jaebin401/RAVEN_hardware/images/link image/base_link.png

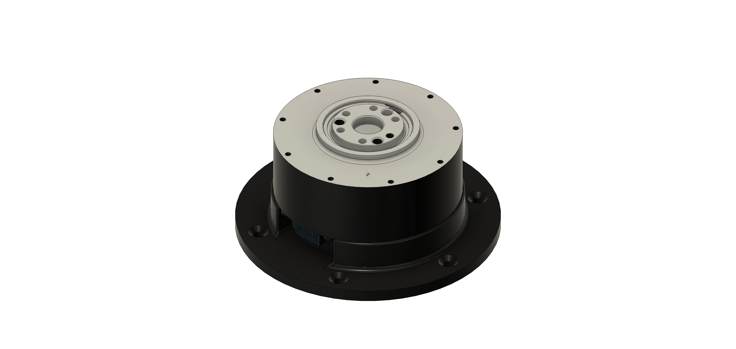
images/link image/base_link.png
