jaebin401/RAVEN_hardware/images/link image/ForeArm_link.png

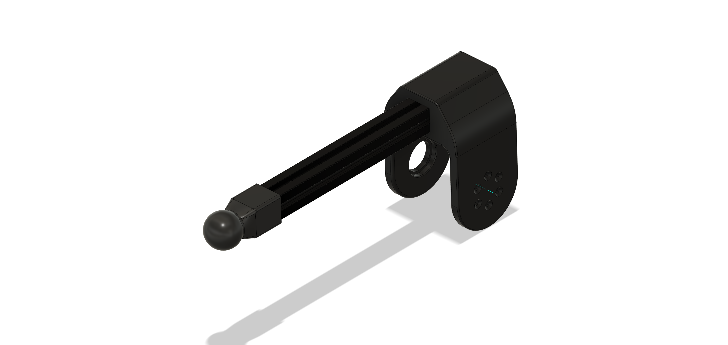
images/link image/ForeArm_link.png
