jaebin401/RAVEN_hardware/images/link image/Shoulder_link.png

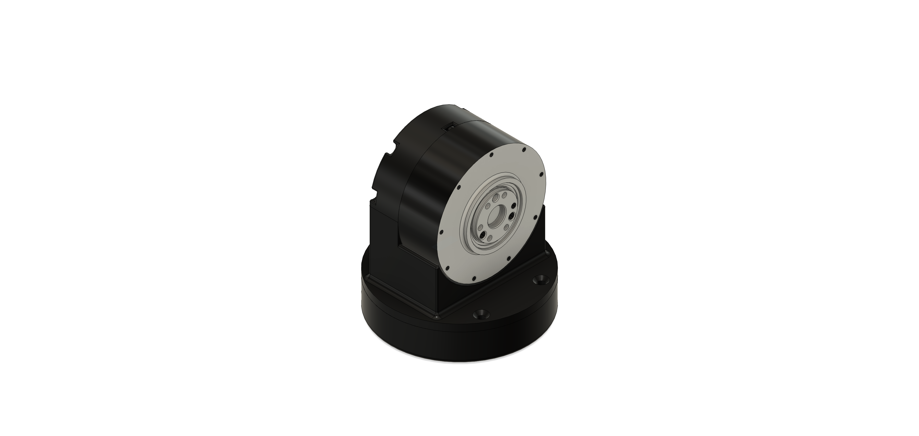
images/link image/Shoulder_link.png
