jaebin401/RAVEN_hardware/images/link image/UpperArm_link.png

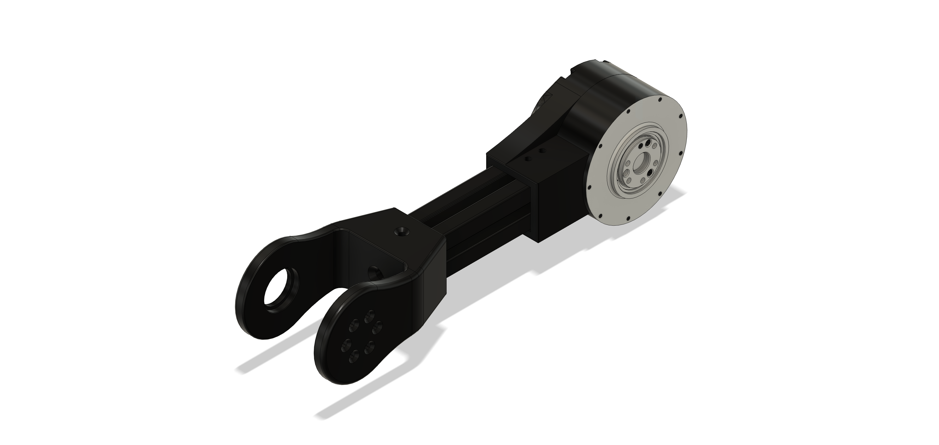
images/link image/UpperArm_link.png
