jaebin401/RAVEN_hardware/images/part image/RVN_3DP_ForeArm_Drive.png

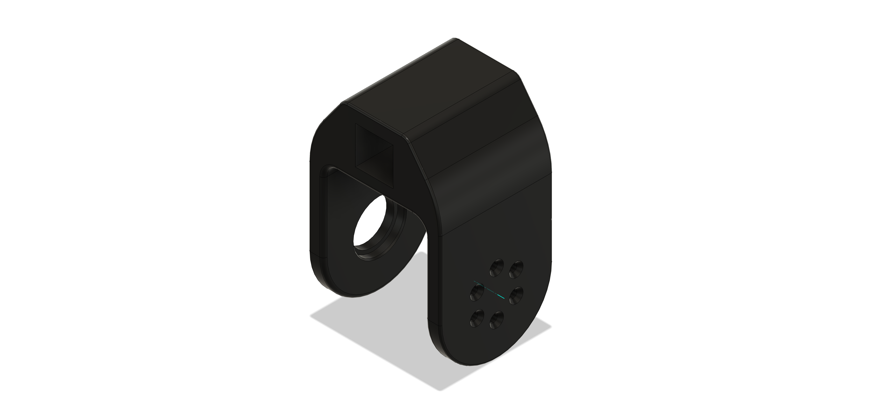
images/part image/RVN_3DP_ForeArm_Drive.png
