jaebin401/RAVEN_hardware/images/part image/RVN_BUY_ForeArm_Frame v1.png

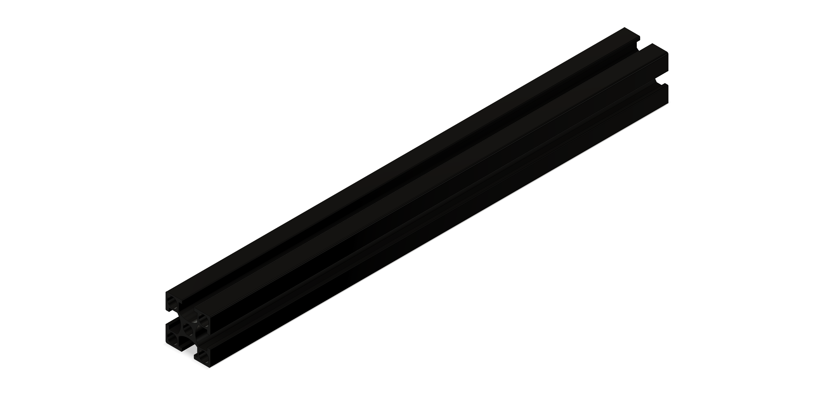
images/part image/RVN_BUY_ForeArm_Frame v1.png
