jaebin401/RAVEN_hardware/images/part image/RVN_BUY_UpperArm_Frame.png

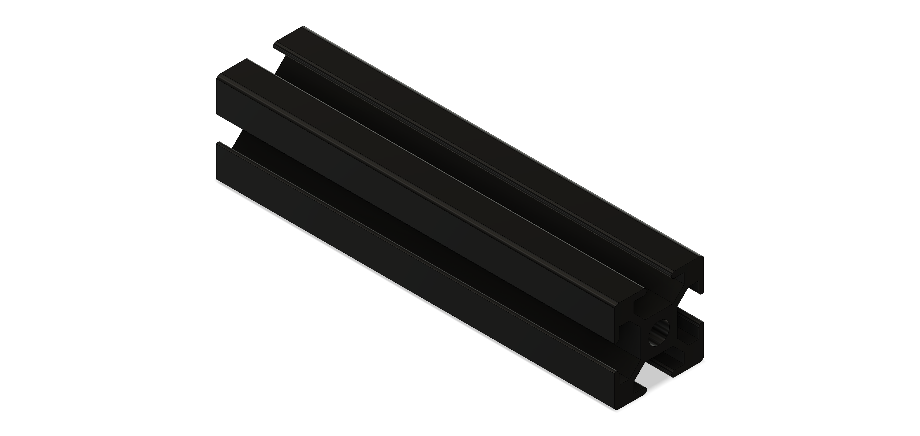
images/part image/RVN_BUY_UpperArm_Frame.png
