jaebin401/RAVEN_hardware/images/RAVEN on RViz2.png

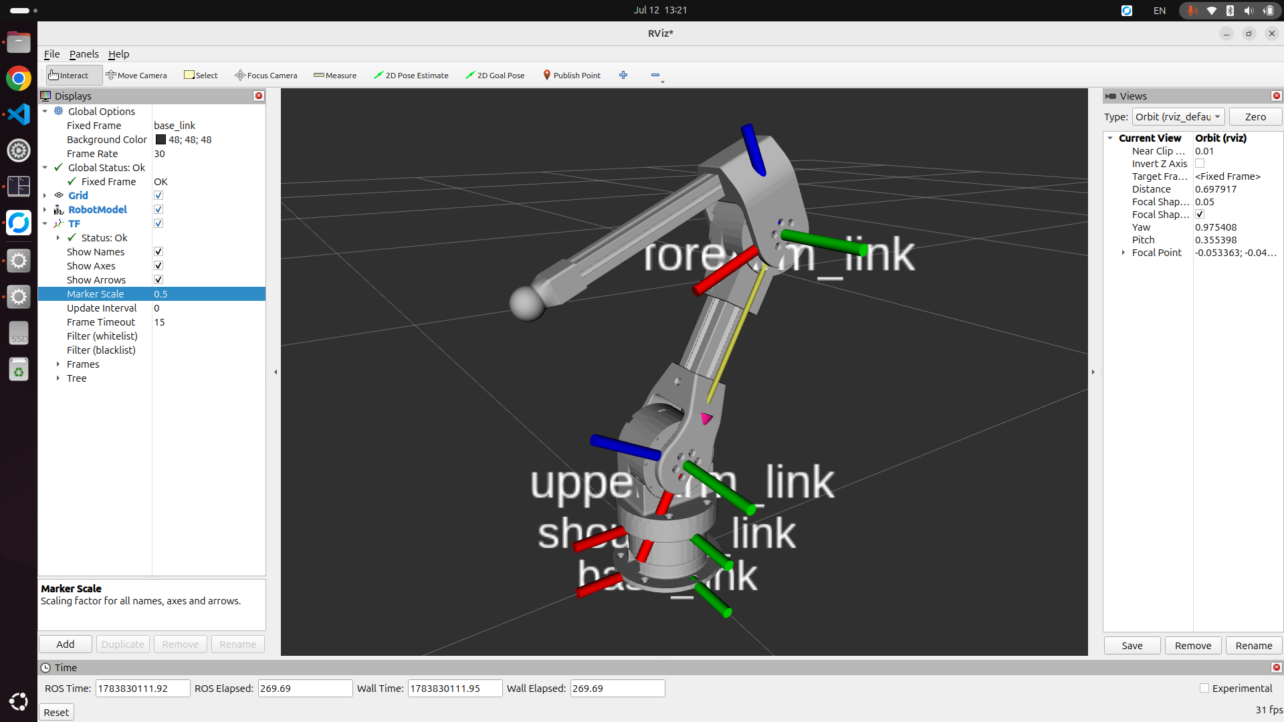
images/RAVEN on RViz2.png
