jaebin401/RAVEN_hardware/images/RAVEN_in_real.jpeg

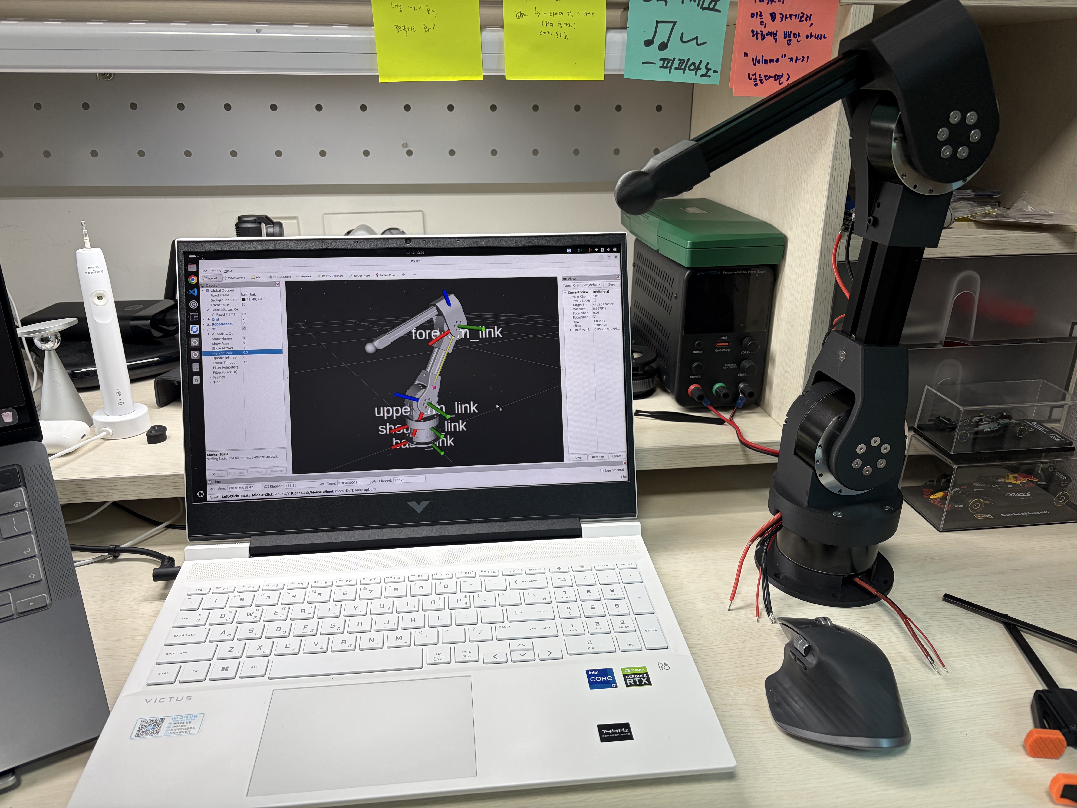
images/RAVEN_in_real.jpeg
