jaebin401/RAVEN_hardware/images/RAVEN_profile.png

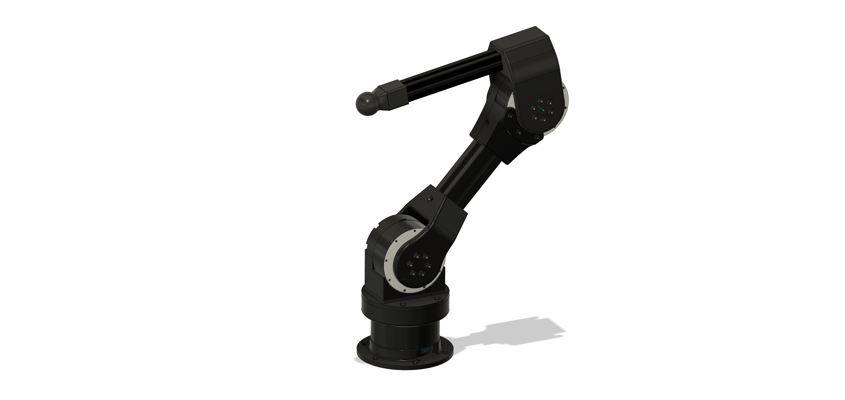
images/RAVEN_profile.png
