jaebin401/RAVEN_hardware/images/RAVEN_profile_portrait.png

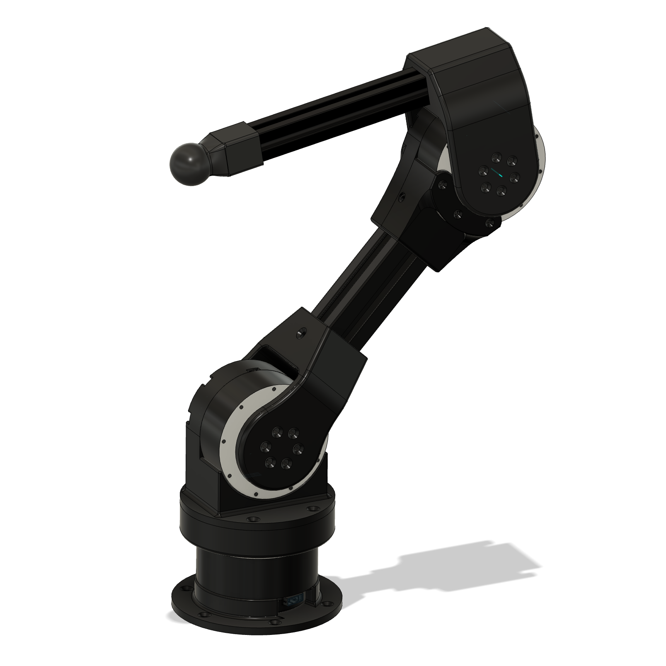
images/RAVEN_profile_portrait.png
