jaebin401/RAVEN_hardware/cad/Link files - .STEP/base_link.step

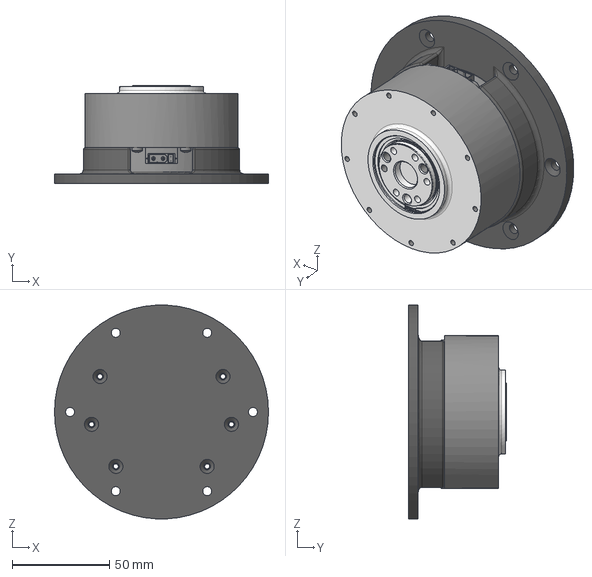
[picture p14: CAD file, 2026-07-12]
cad/Link files - .STEP/base_link.step
110.0 x 50.4 x 109.8 mm
base_link_1
RS02
