jaebin401/RAVEN_hardware/cad/part files - .3mf/030_RVN_3DP_ForeArm_Drive_v1.3mf

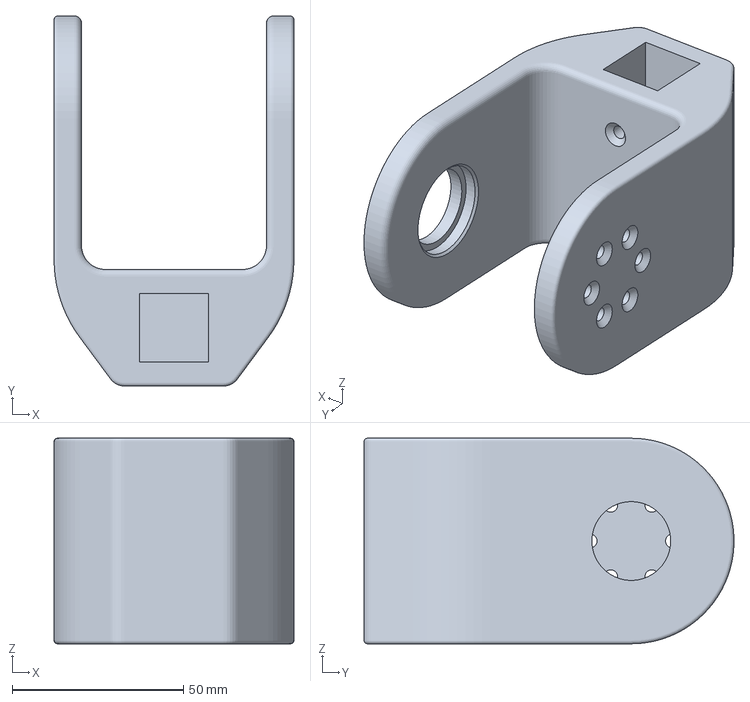
[picture p15: CAD file, 2026-07-14]
cad/part files - .3mf/030_RVN_3DP_ForeArm_Drive_v1.3mf
70.0 x 108.0 x 60.0 mm
