jaebin401/RAVEN_hardware/part files/RVN_BUY_RS02.SLDPRT

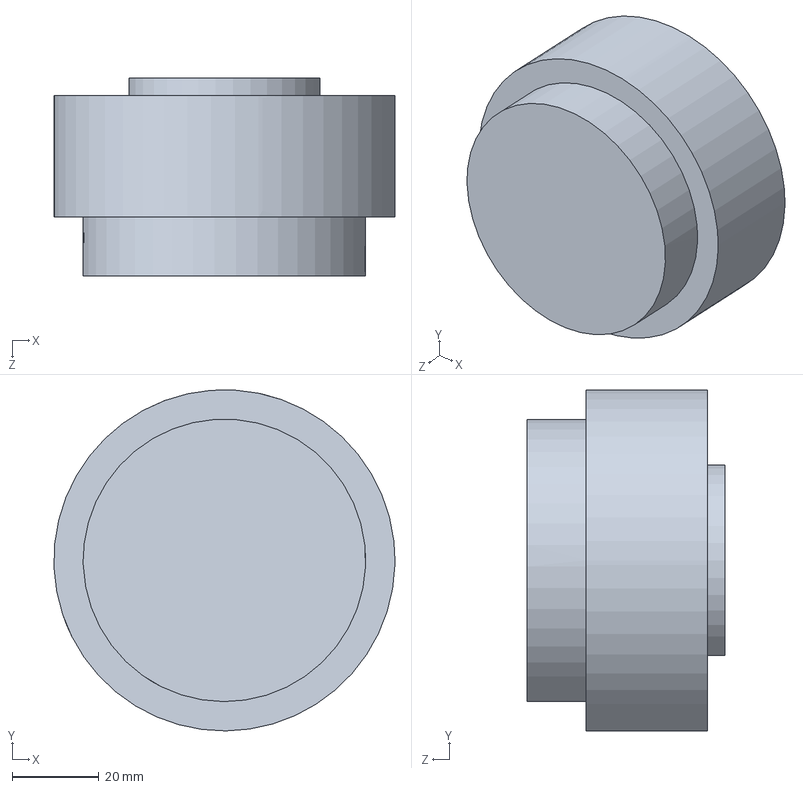
[picture p16: CAD file, 2026-05-31]
part files/RVN_BUY_RS02.SLDPRT
78.5 x 78.4 x 45.5 mm
