jaebin401/RAVEN_hardware/urdf/meshes/upperArm_link.STL

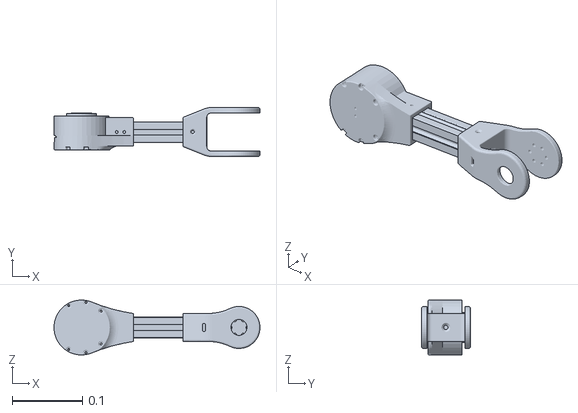
[picture p17: CAD file, 2026-07-11]
urdf/meshes/upperArm_link.STL
0.294 x 0.07 x 0.0785
