jaebin401/RAVEN_hardware/cad/Link files - .STEP/UpperArm_link.step

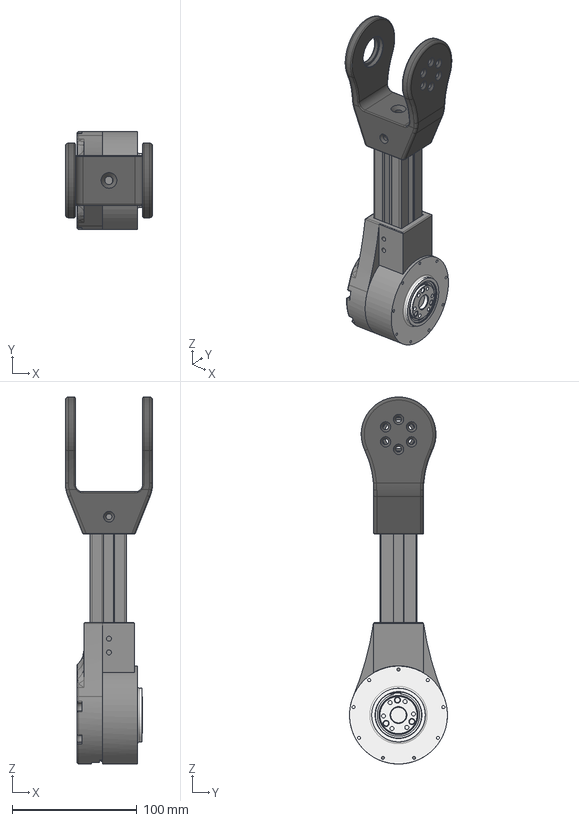
[picture p18: CAD file, 2026-07-12]
cad/Link files - .STEP/UpperArm_link.step
70.0 x 78.5 x 294.2 mm
RVN_3DP_UpperArm_Drive_profile
GFSP6-3030-130
RVN_3DP_UpperArm_MotorMount
RS02
