jaebin401/RAVEN_hardware/cad/part files - .3mf/010_RVN_3DP_Shoulder_MotorMount_v1.3mf

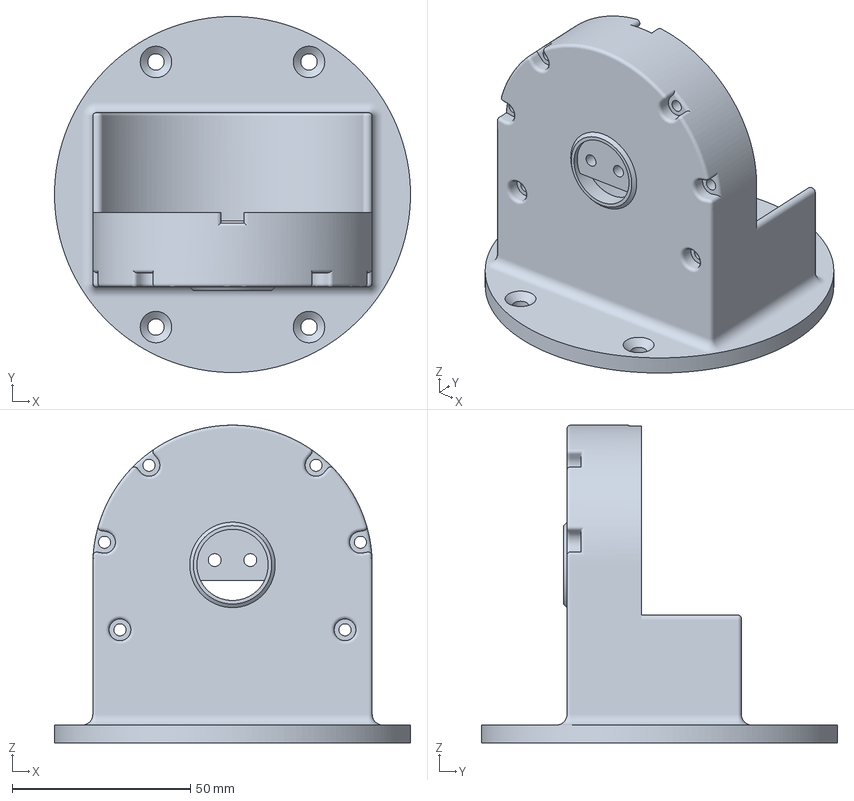
[picture p19: CAD file, 2026-07-14]
cad/part files - .3mf/010_RVN_3DP_Shoulder_MotorMount_v1.3mf
100.0 x 100.0 x 89.3 mm
