jaebin401/RAVEN_hardware/part files/RVN_3DP_Shoulder_Drive_v1.step

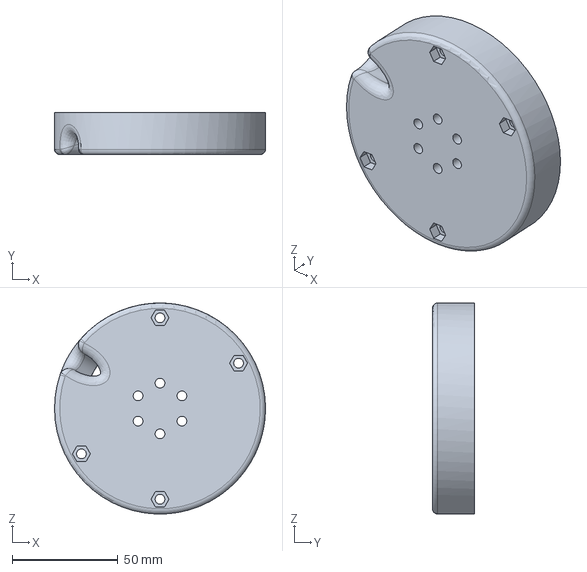
[picture p20: CAD file, 2026-05-31]
part files/RVN_3DP_Shoulder_Drive_v1.step
100.0 x 20.0 x 100.0 mm
