jaebin401/RAVEN_hardware/urdf/meshes/foreArm_link.STL

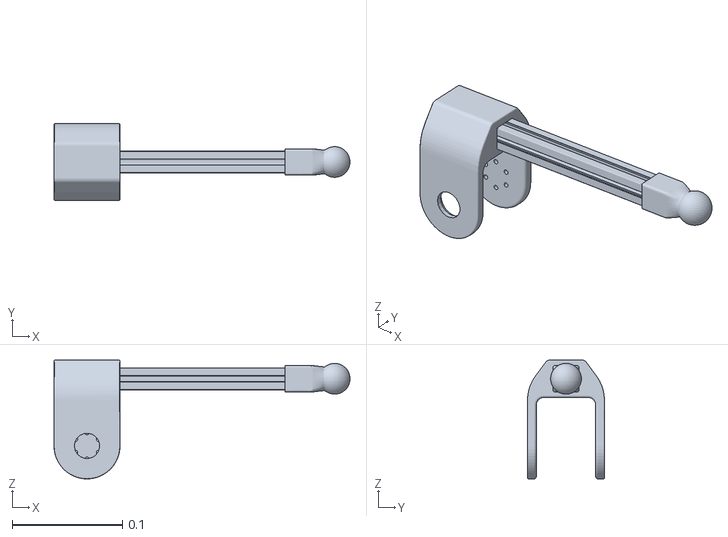
[picture p21: CAD file, 2026-07-11]
urdf/meshes/foreArm_link.STL
0.269 x 0.07 x 0.108
