jaebin401/RAVEN_hardware/cad/Link files - .STEP/ForeArm_link.step

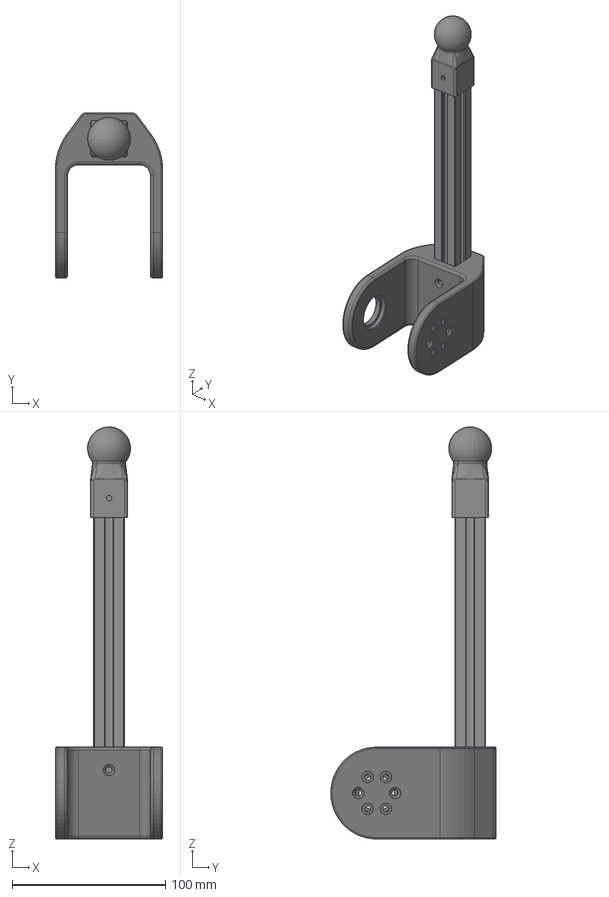
[picture p22: CAD file, 2026-07-12]
cad/Link files - .STEP/ForeArm_link.step
70.0 x 108.0 x 268.9 mm
RVN_BUY_ForeArm_Frame
RVN_3DP_ForeArm_Drive_v3
RVN_3DP_ForeArm_EndEffecter
