jaebin401/RAVEN_hardware/cad/part files - .3mf/031_RVN_3DP_ForeArm_EndEffector_v2.3mf

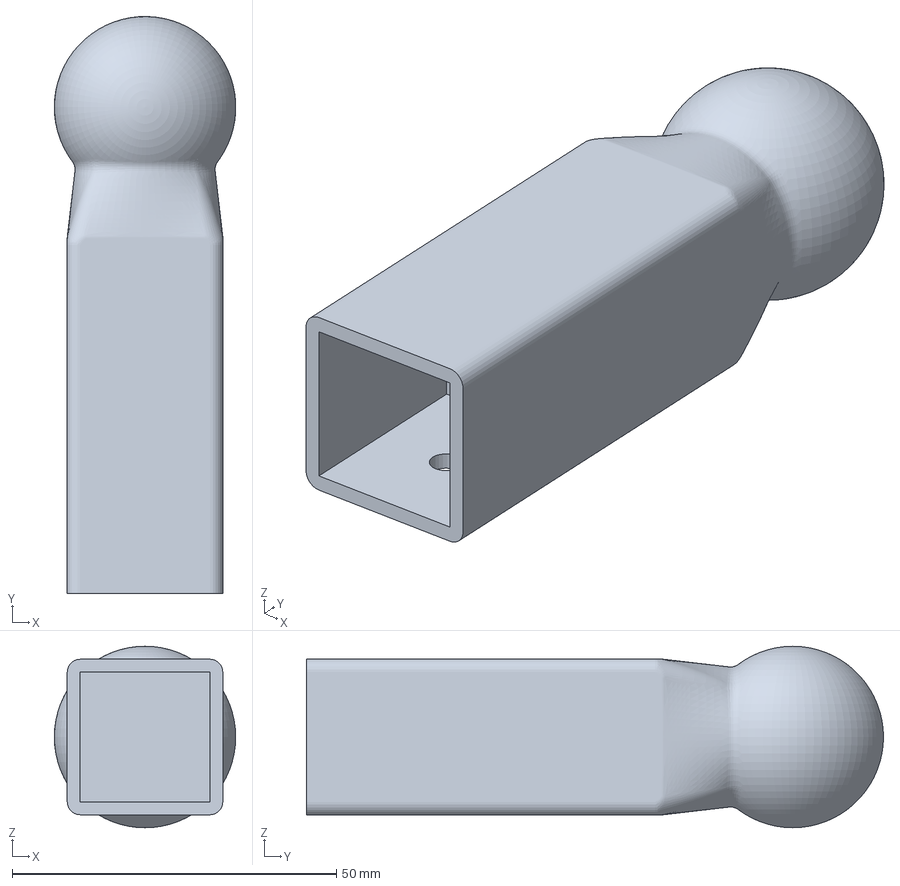
[picture p23: CAD file, 2026-07-14]
cad/part files - .3mf/031_RVN_3DP_ForeArm_EndEffector_v2.3mf
28.0 x 89.0 x 28.0 mm
