jaebin401/RAVEN_hardware/part files/RVN_3DP_UpperArm_Drive_v1.step

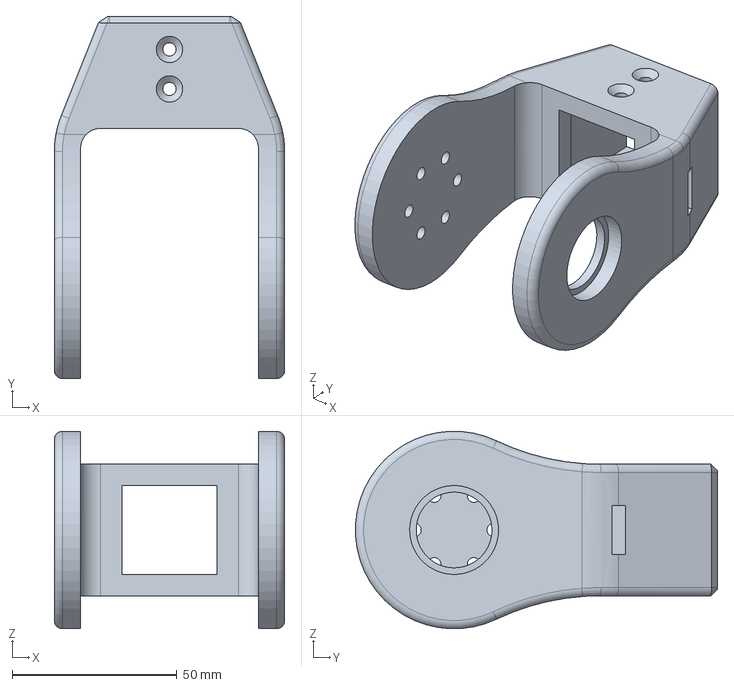
[picture p24: CAD file, 2026-05-31]
part files/RVN_3DP_UpperArm_Drive_v1.step
70.0 x 109.9 x 59.9 mm
