jaebin401/RAVEN_hardware/urdf/meshes/base_link.STL

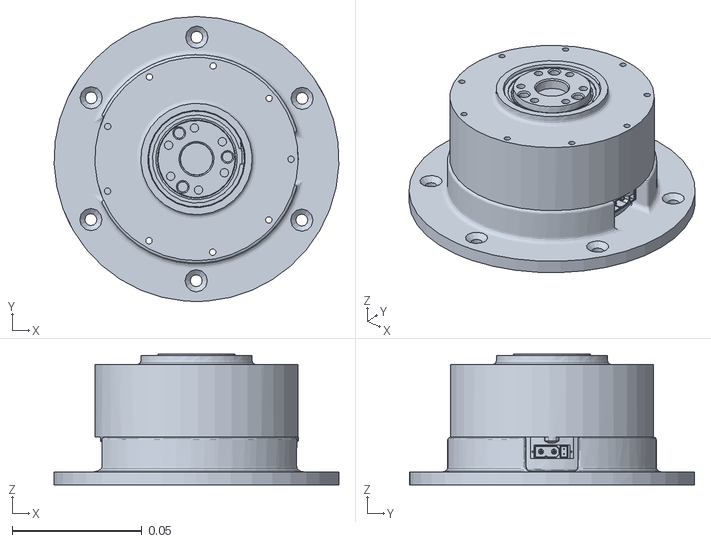
[picture p25: CAD file, 2026-07-11]
urdf/meshes/base_link.STL
0.11 x 0.11 x 0.0504
