jaebin401/RAVEN_hardware/cad/Link files - .STEP/Shoulder_link.step

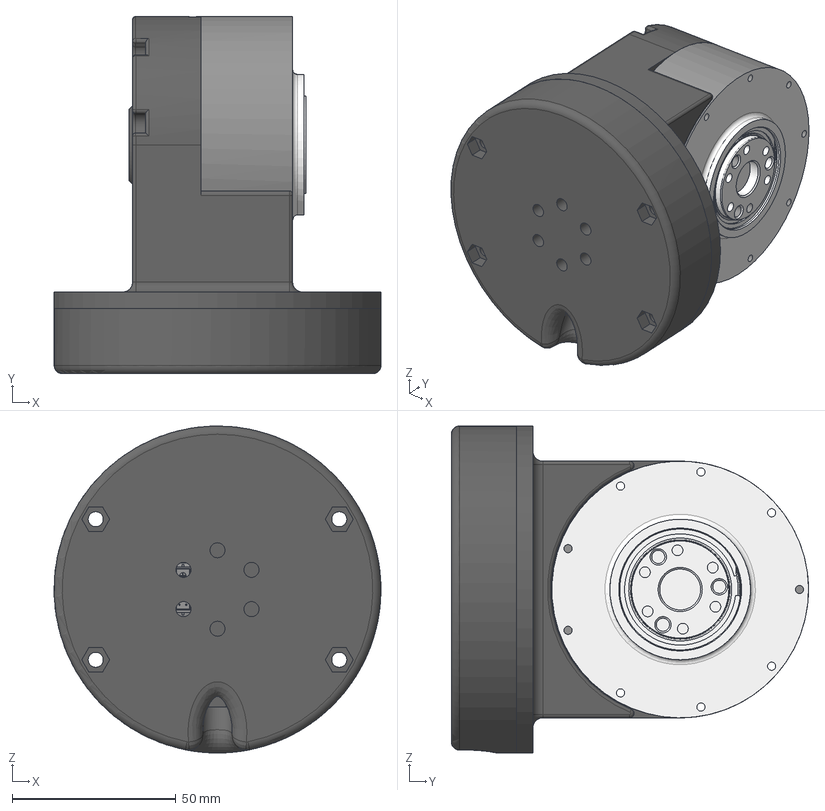
[picture p26: CAD file, 2026-07-12]
cad/Link files - .STEP/Shoulder_link.step
100.0 x 109.3 x 100.0 mm
RVN_3DP_Shoulder_Drive
RVN_3DP_Shoulder_MotorMount
RS02
