jaebin401/RAVEN_hardware/cad/part files - .3mf/000_RVN_3DP_Base_MotorMount_v1.3mf

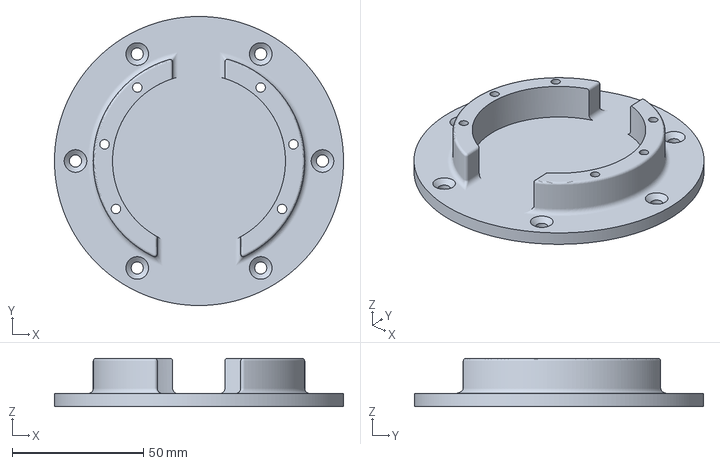
[picture p27: CAD file, 2026-07-14]
cad/part files - .3mf/000_RVN_3DP_Base_MotorMount_v1.3mf
110.0 x 110.0 x 18.4 mm
