jaebin401/RAVEN_hardware/urdf/meshes/shoulder_link.STL

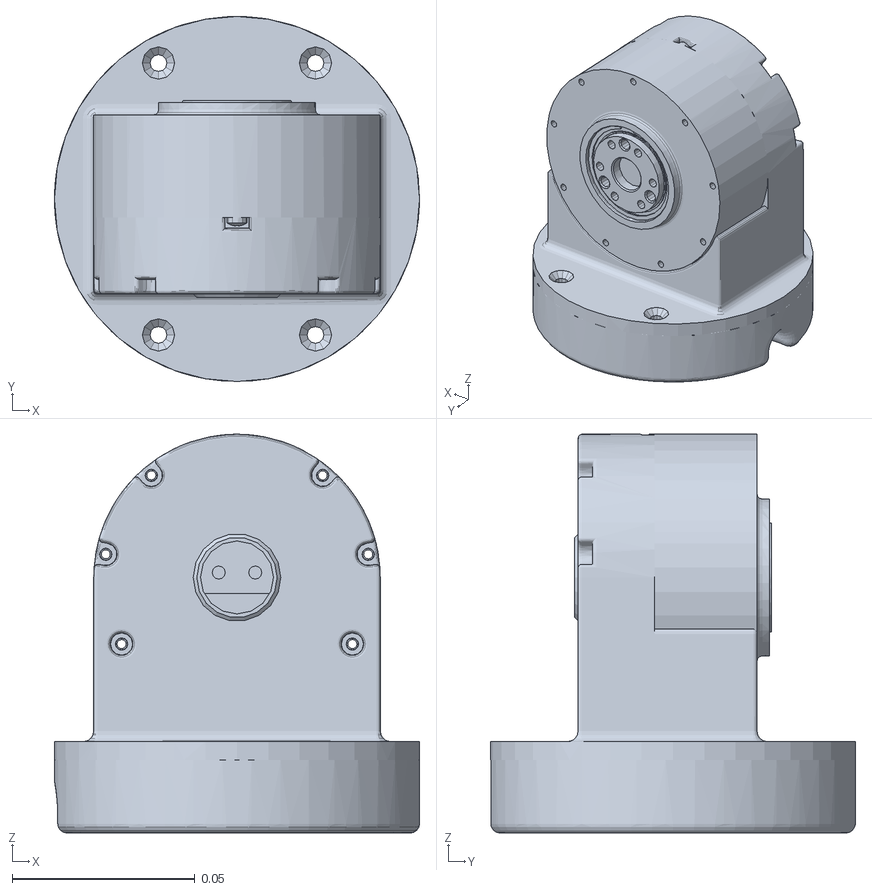
[picture p28: CAD file, 2026-07-11]
urdf/meshes/shoulder_link.STL
0.1 x 0.1 x 0.109
