jaebin401/RAVEN_hardware/cad/part files - .3mf/012_RVN_3DP_Shoulder_InnerShaft_v4.3mf

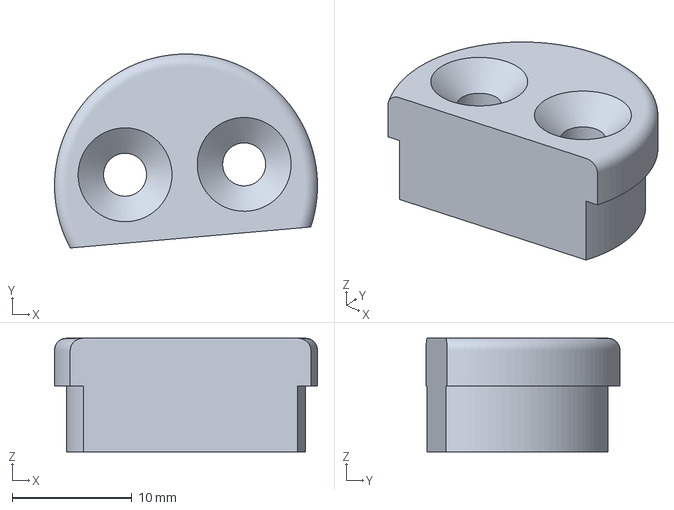
[picture p29: CAD file, 2026-07-14]
cad/part files - .3mf/012_RVN_3DP_Shoulder_InnerShaft_v4.3mf
22.0 x 16.2 x 9.50 mm
