jaebin401/RAVEN_hardware/part files/RVN_3DP_ForeArm_Drive_v2.step

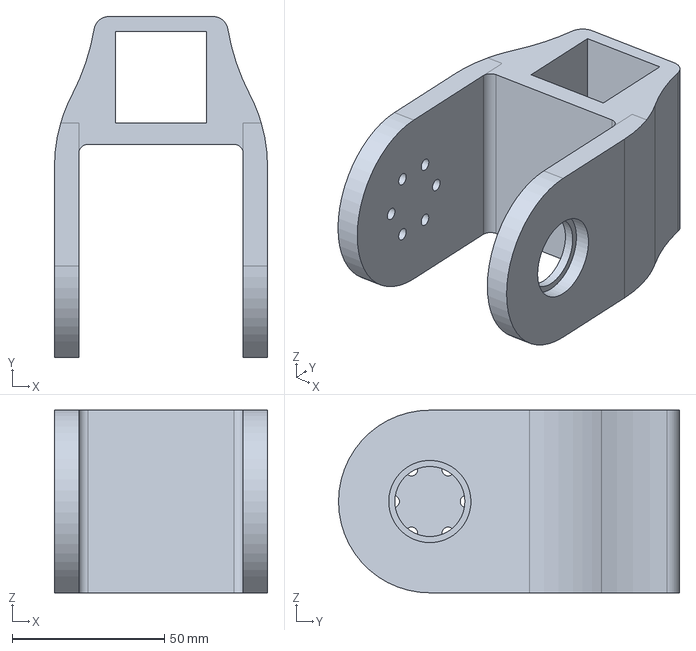
[picture p30: CAD file, 2026-05-31]
part files/RVN_3DP_ForeArm_Drive_v2.step
70.0 x 112.0 x 60.0 mm
