jaebin401/RAVEN_hardware/cad/part files - .3mf/021_RVN_3DP_UpperArm_Drive_v3.3mf

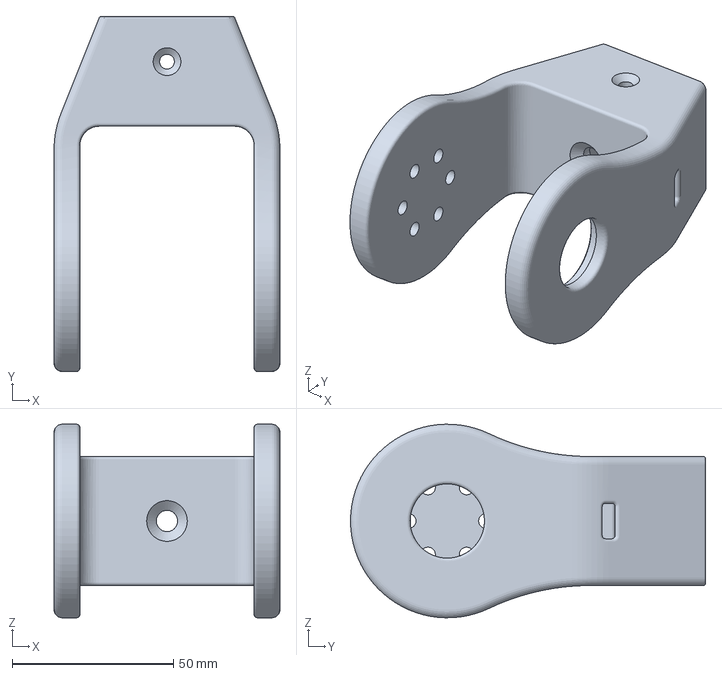
[picture p31: CAD file, 2026-07-14]
cad/part files - .3mf/021_RVN_3DP_UpperArm_Drive_v3.3mf
70.0 x 110.0 x 60.0 mm
