jaebin401/RAVEN_hardware/part files/RVN_BUY_ForeArm_CarbonTube250.step

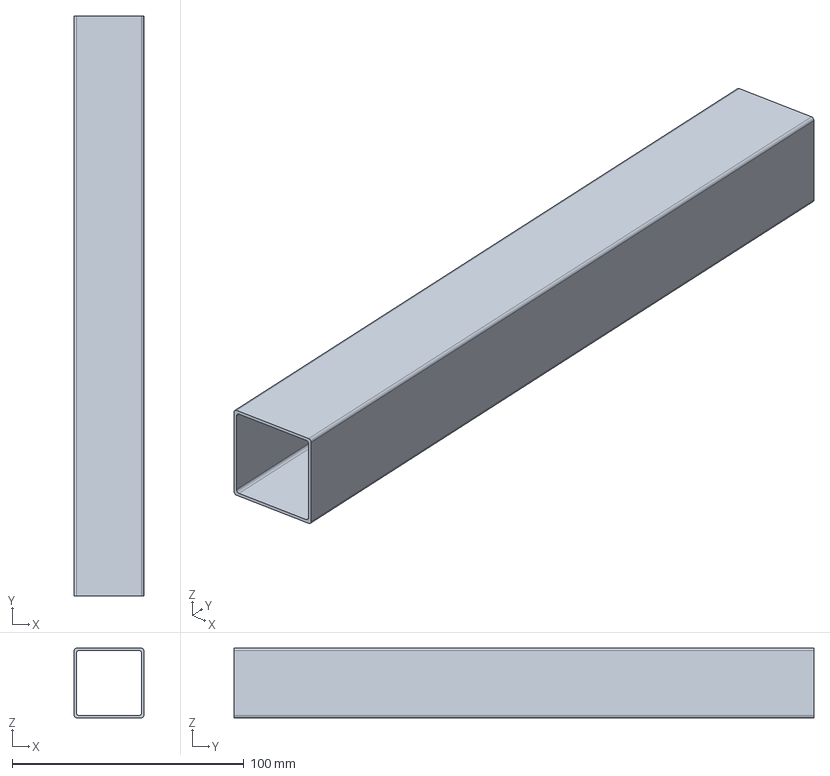
[picture p32: CAD file, 2026-05-31]
part files/RVN_BUY_ForeArm_CarbonTube250.step
30.0 x 250.0 x 30.0 mm
