jaebin401/RAVEN_hardware/cad/part files - .3mf/020_RVN_3DP_UpperArm_MotorMount_v2.3mf

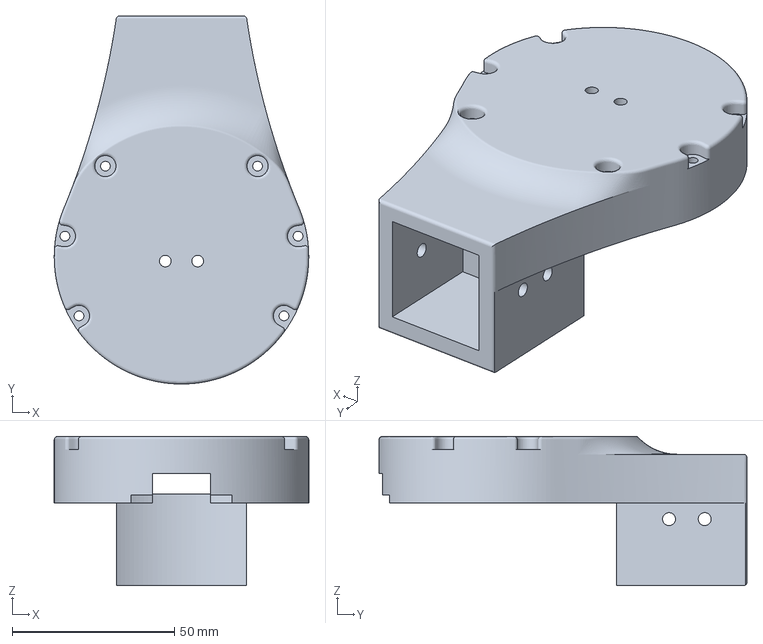
[picture p33: CAD file, 2026-07-14]
cad/part files - .3mf/020_RVN_3DP_UpperArm_MotorMount_v2.3mf
78.5 x 113.5 x 46.0 mm
