jaebin401/RAVEN_hardware/part files/RVN_3DP_UpperArm_MotorMount_v1.step

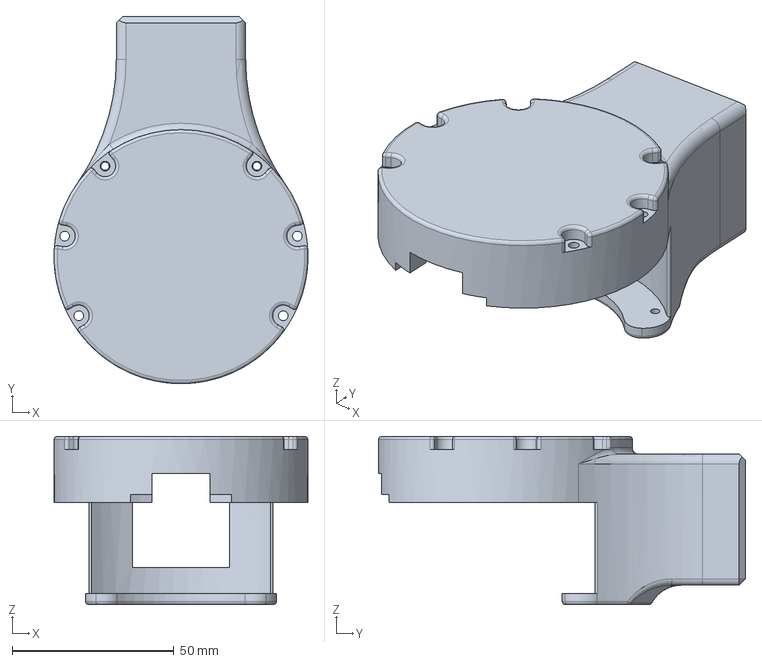
[picture p34: CAD file, 2026-05-31]
part files/RVN_3DP_UpperArm_MotorMount_v1.step
78.5 x 113.5 x 52.0 mm
