jaebin401/RAVEN_hardware/part files/RVN_BUY_UpperArm_CarbonTube160.step

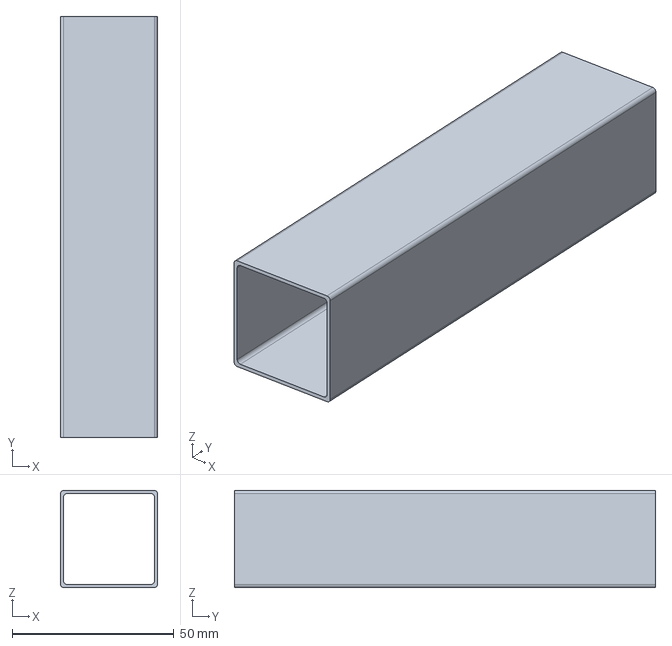
[picture p35: CAD file, 2026-05-31]
part files/RVN_BUY_UpperArm_CarbonTube160.step
30.0 x 130.0 x 30.0 mm
