jaebin401/RAVEN_hardware/assembly/RVN_ForeArm_ASM_v1.SLDASM

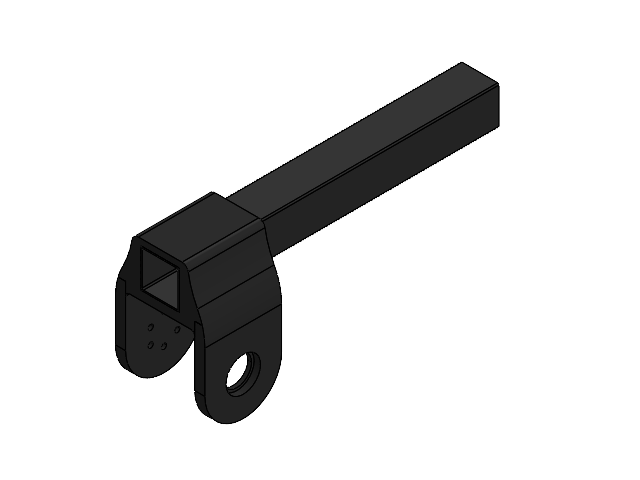
[picture p36: CAD file, 2026-07-11]
assembly/RVN_ForeArm_ASM_v1.SLDASM
RVN_3DP_ForeArm_Drive_v2.step
RVN_BUY_ForeArm_CarbonTube250.step
