jaebin401/RAVEN_hardware/assembly/RVN_Base_ASM_v1.SLDASM

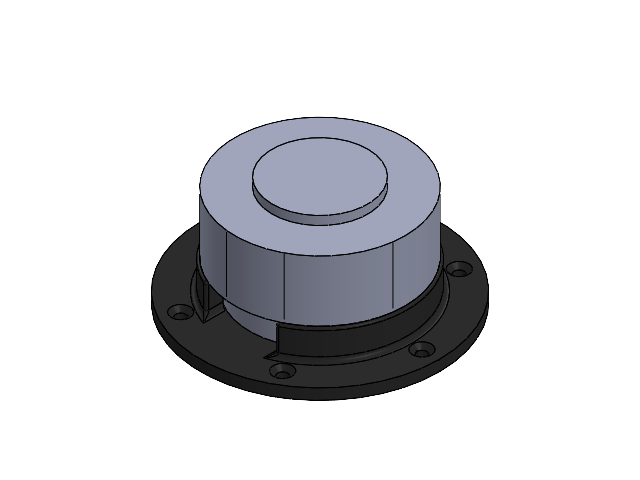
[picture p37: CAD file, 2026-07-11]
assembly/RVN_Base_ASM_v1.SLDASM
RVN_3DP_Base_MotorMount_v1.step
RVN_BUY_RS02
