jaebin401/RAVEN_hardware/assembly/RAVEN_reassembly.SLDASM

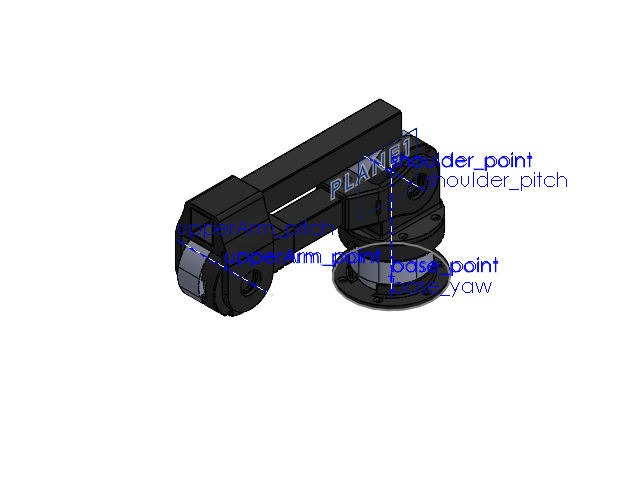
[picture p39: CAD file, 2026-06-02]
assembly/RAVEN_reassembly.SLDASM
RVN_3DP_Base_MotorMount_v1.step
RVN_BUY_RS02 x 3
RVN_3DP_Shoulder_Drive_v1.step
RVN_3DP_Shoulder_MotorMount.step
RVN_3DP_UpperArm_Drive_v1.step
RVN_3DP_UpperArm_MotorMount_v1.step
RVN_BUY_UpperArm_CarbonTube160.step
RVN_3DP_ForeArm_Drive_v2.step
RVN_BUY_ForeArm_CarbonTube250.step
