jaebin401/RAVEN_hardware/(list of files, cad)

Other CAD files:
part files/RVN_3DP_Base_MotorMount_v1.step
cad/part files - .3mf/011_RVN_3DP_Shoulder_Drive_v1.3mf
part files/RVN_3DP_Shoulder_MotorMount.step
cad/modeling files - .f3d/000_RVN_3DP_Base_MotorMount.f3d
cad/modeling files - .f3d/010_RVN_3DP_Shoulder_MotorMount.f3d
cad/modeling files - .f3d/011_RVN_3DP_Shoulder_Drive.f3d
cad/modeling files - .f3d/012_RVN_3DP_Shoulder_InnerShaft.f3d
cad/modeling files - .f3d/020_RVN_3DP_UpperArm_MotorMount.f3d
cad/modeling files - .f3d/021_RVN_3DP_UpperArm_Drive.f3d
cad/modeling files - .f3d/030_RVN_3DP_ForeArm_Drive.f3d
cad/modeling files - .f3d/031_RVN_3DP_ForeArm_EndEffector.f3d
