jaebin401/RAVEN_hardware/images/RAVEN_assemble1.jpeg

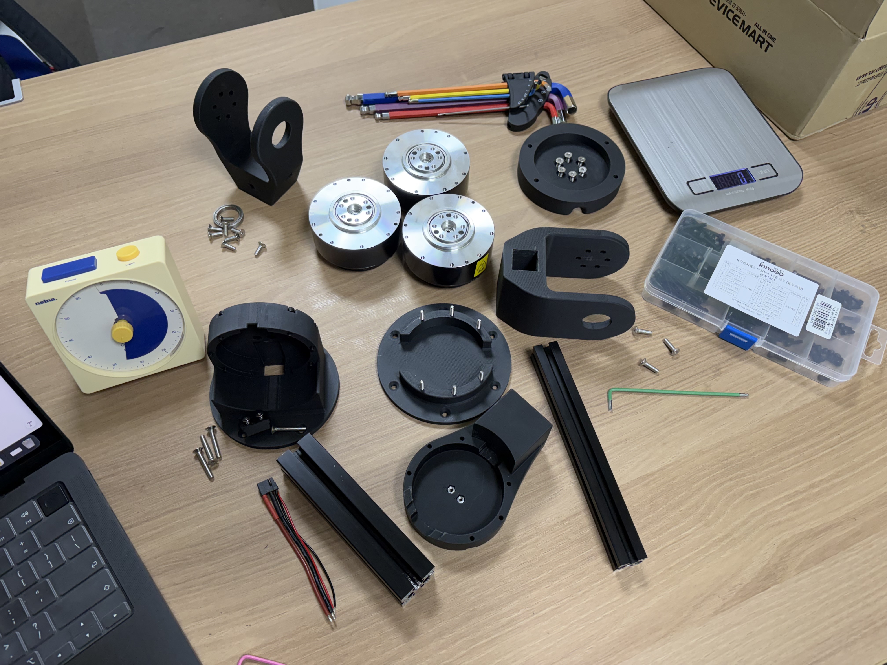
images/RAVEN_assemble1.jpeg
