jaebin401/RAVEN_hardware/urdf/test.md

RVN_ForeArm_ASM_v1의 물성치
설정: 기본
좌표계: -- 기본 --

질량 = 169.41 그램

볼륨 = 169409.23 입방 밀리미터

면적 = 96412.63  평방 밀리미터

중심: ( 밀리미터 )
X = -5.34
Y = 19.69
Z = 1013.74

주관성축(Principal axes of inertia)과 주관성 모멘트(principal moments of inertia): ( 그램 *  평방 밀리미터 )
질량 중심에서 얻음.
Ix = (-0.01, -0.19,  0.98)   	Px = 214707.30
Iy = (-0.12, -0.97, -0.19)   	Py = 511405.21
Iz = ( 0.99, -0.12, -0.02)   	Pz = 544124.29

관성 모멘트: ( 그램 *  평방 밀리미터 )
질량 중심에서 계산되며 출력 좌표계에 맞추어집니다. (양의 텐서 기호법 사용)
Lxx = 543611.24	Lxy = 4395.01	Lxz = -1708.31
Lyx = 4395.01	Lyy = 501126.95	Lyz = -55543.98
Lzx = -1708.31	Lzy = -55543.98	Lzz = 225498.61

관성 모멘트: ( 그램 *  평방 밀리미터 )
출력 사용자 좌표계에서 얻은 값. (양의 텐서 기호법 사용)
Ixx = 174705080.81	Ixy = -13416.02	Ixz = -918584.93
Iyx = -13416.02	Iyy = 174601728.48	Iyz = 3326398.14
Izx = -918584.93	Izy = 3326398.14	Izz = 296024.13
