jaebin401/RAVEN_hardware/(commit log)

2026-05-31 add STEP files
    [Carbon Tube 160.step, Carbon Tube 250.step, RVN_3DP_Base_MotorMount_v1.step, RVN_3DP_ForeArm_Drive_v2.step, RVN_3DP_Shoulder_Drive_v1.step, RVN_3DP_Shoulder_MotorMount.step, RVN_3DP_UpperArm_Drive_v1.step, RVN_3DP_UpperArm_MotorMount_v1.step]
2026-05-31 rename carbone tube file
    [RVN_BUY_ForeArm_CarbonTube250.step, RVN_BUY_UpperArm_CarbonTube160.step]
2026-05-31 add Robstride 02 defeature file
    [RVN_BUY_RS02.SLDPRT]
2026-05-31 add assembly file: these are links
    [RVN_Base_ASM_v1.SLDASM, RVN_ForeArm_ASM_v1.SLDASM, RVN_Shoulder_ASM_v1.SLDASM, RVN_UpperArm_ASM_v1.SLDASM]
2026-05-31 add full assembly of RAVEN manipulator
    [RAVEN_assembly.SLDASM]
2026-05-31 mass override
    [RAVEN_assembly.SLDASM, RVN_BUY_RS02.SLDPRT]
2026-05-31 export URDF
    [base_link.STL, foreArm_link.STL, shoulder_link.STL, upperArm_link.STL, urdf.csv, urdf.urdf]
2026-05-31 rename urdf file
    [RAVEN.urdf]
2026-05-31 solve mesh file directory
    [urdf.urdf]
2026-05-31 add forearm link rotation
    [RAVEN.urdf]
2026-05-31 update assembly file
    [RAVEN_assembly.SLDASM]
2026-05-31 rename folder name
    [RAVEN_assembly.SLDASM, RVN_Base_ASM_v1.SLDASM, RVN_ForeArm_ASM_v1.SLDASM, RVN_Shoulder_ASM_v1.SLDASM, RVN_UpperArm_ASM_v1.SLDASM]
2026-05-31 rename joint axis
    [RAVEN.urdf]
2026-06-02 modify assembly files
    [RAVEN_assembly.SLDASM]
2026-06-02 soldiworks shoulder yaw 축 정렬 오류 해결
    [RAVEN_assembly.SLDASM]
2026-06-02 reassembly result: STL reload, 축 정렬 문제의 원인이 이 STL이었음
    [base_link.STL, foreArm_link.STL, shoulder_link.STL, upperArm_link.STL]
2026-06-02 do solidworks assembly again: it caused axis unmatch problem
    [RAVEN_reassembly.SLDASM, RAVEN_reassembly.urdf]
2026-06-02 add reassembly urdf
    [RAVEN_assembly2.urdf]
2026-06-02 rename robot
    [RAVEN.urdf, RAVEN_abs.urdf]
2026-06-02 save file
    [RAVEN_assembly.SLDASM, RAVEN_reassembly.SLDASM]
2026-06-02 add absolute mesh file directory version urdf
    [RAVEN_abs.urdf]
2026-06-02 solve file directory error
    [RAVEN_abs.urdf]
2026-06-02 add urdf cheat sheet
2026-06-02 remvoe extra urdfs
    [RAVEN_assembly2.urdf, RAVEN_reassembly.urdf]
2026-06-04 물성치 테스트
2026-07-11 minor update
    [RVN_Base_ASM_v1.SLDASM, RVN_ForeArm_ASM_v1.SLDASM]
2026-07-11 add URDF of RAVEN_profile ver
    [RAVEN_assembly_v2.csv, RAVEN_assembly_v2.urdf, RS02_1.step.SLDPRT, RS02_2.step.SLDPRT, base_link.STL, foreArm_link.STL, shoulder_link.STL, upperArm_link.STL]
2026-07-12 add STEP files of links
    [ForeArm_link.step, Shoulder_link.step, UpperArm_link.step, base_link.step]
2026-07-12 file organizing
    [RAVEN.urdf, RAVEN_abs.urdf, RAVEN_assembly.SLDASM, RAVEN_assembly_v2.csv, RAVEN_reassembly.SLDASM, RVN_3DP_Base_MotorMount_v1.step, RVN_3DP_ForeArm_Drive_v2.step, RVN_3DP_Shoulder_Drive_v1.step]
2026-07-12 urdf final version
    [RAVEN.urdf]
2026-07-12 remove legacy folder
    [RAVEN.urdf, RAVEN_abs.urdf, RAVEN_assembly.SLDASM, RAVEN_reassembly.SLDASM, RVN_3DP_Base_MotorMount_v1.step, RVN_3DP_ForeArm_Drive_v2.step, RVN_3DP_Shoulder_Drive_v1.step, RVN_3DP_Shoulder_MotorMount.step]
2026-07-14 add cad directory
    [000_RVN_3DP_Base_MotorMount_v1.3mf, 010_RVN_3DP_Shoulder_MotorMount_v1.3mf, 011_RVN_3DP_Shoulder_Drive_v1.3mf, 012_RVN_3DP_Shoulder_InnerShaft_v4.3mf, 020_RVN_3DP_UpperArm_MotorMount_v2.3mf, 021_RVN_3DP_UpperArm_Drive_v3.3mf, 030_RVN_3DP_ForeArm_Drive_v1.3mf, 031_RVN_3DP_ForeArm_EndEffector_v2.3mf]
2026-07-14 add bom draft
2026-07-26 rename folder title
    [000_RVN_3DP_Base_MotorMount_v1.3mf, 010_RVN_3DP_Shoulder_MotorMount_v1.3mf, 011_RVN_3DP_Shoulder_Drive_v1.3mf, 012_RVN_3DP_Shoulder_InnerShaft_v4.3mf, 020_RVN_3DP_UpperArm_MotorMount_v2.3mf, 021_RVN_3DP_UpperArm_Drive_v3.3mf, 030_RVN_3DP_ForeArm_Drive_v1.3mf, 031_RVN_3DP_ForeArm_EndEffector_v2.3mf]
2026-07-26 add f3d files
    [000_RVN_3DP_Base_MotorMount.f3d, 010_RVN_3DP_Shoulder_MotorMount.f3d, 011_RVN_3DP_Shoulder_Drive.f3d, 012_RVN_3DP_Shoulder_InnerShaft.f3d, 020_RVN_3DP_UpperArm_MotorMount.f3d, 021_RVN_3DP_UpperArm_Drive.f3d, 030_RVN_3DP_ForeArm_Drive.f3d, 031_RVN_3DP_ForeArm_EndEffector.f3d]
