jaebin401/RAVEN_hardware/(notices)

Notices in the files:
README.md:
License: CERN-OHL-S 2.0
